ThorstenBr/WifiScope4Hameg/WifiScope/utypes.h

#ifndef _UTYPES_H
#define _UTYPES_H

typedef signed char        Int8;
typedef unsigned char      UInt8;

typedef signed short int   Int16;
typedef unsigned short int UInt16;

typedef signed long        Int32;
typedef unsigned long      UInt32;

typedef unsigned long long ULong64;

#endif // _UTYPES_H
