ThorstenBr/WifiScope4Hameg/(commit log)

2022-10-02 Added timeout handling to web API requests. Use drop down selector instead of toggle switch to select reference signal.
2022-10-02 Added favicon. Added support for binary files to resource compiler. Minor fixes.
    [WifiScope.ino, webserver.ino]
2022-10-02 Set channel voltage selector to "OFF" when channel is disabled.
2022-10-02 Removed delay in disconnect (no longer needed)
    [hameg.ino]
2022-10-03 Added check for Hameg protocol return codes. Improved error reporting.
    [hameg.h, hameg.ino, webserver.ino]
2022-10-03 Improved connection handling. Keep connection alive, to speed up consecutive remote commands. Drop connection after a timeout, so the user can still make manual changes (the device frontend is otherw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
2022-10-03 Introduced error/return codes. Simplify debugging by providing a bit more feedback on the type of communication error.
    [hameg.h, hameg.ino]
2022-10-03 Added workaround for HM407 trigger deadlock. HM407's trigger logic somehow locks up when the RES command is sent and it is immediately followed by another command. A brief delay seems to fix the issu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
    [hameg.h, hameg.ino]
2022-10-04 Automatic browser update interval Continuously poll the Hameg device status and captured measurement data.
2022-10-04 Updated example screen shot to match current browser interface.
2022-10-04 Corrected device URL. Removed the hardcoded device URL from the html file. Provide development option instead to specify a remote device URL as a parameter.
    [WifiScope.ino, WifiScopeConfig.h]
2022-10-06 Corrected "UPDATE" button behaviour when device does not reply.
